rwhitby/glasgow-addons/hardware/usb-pd-addon/usb-pd-addon.pdf

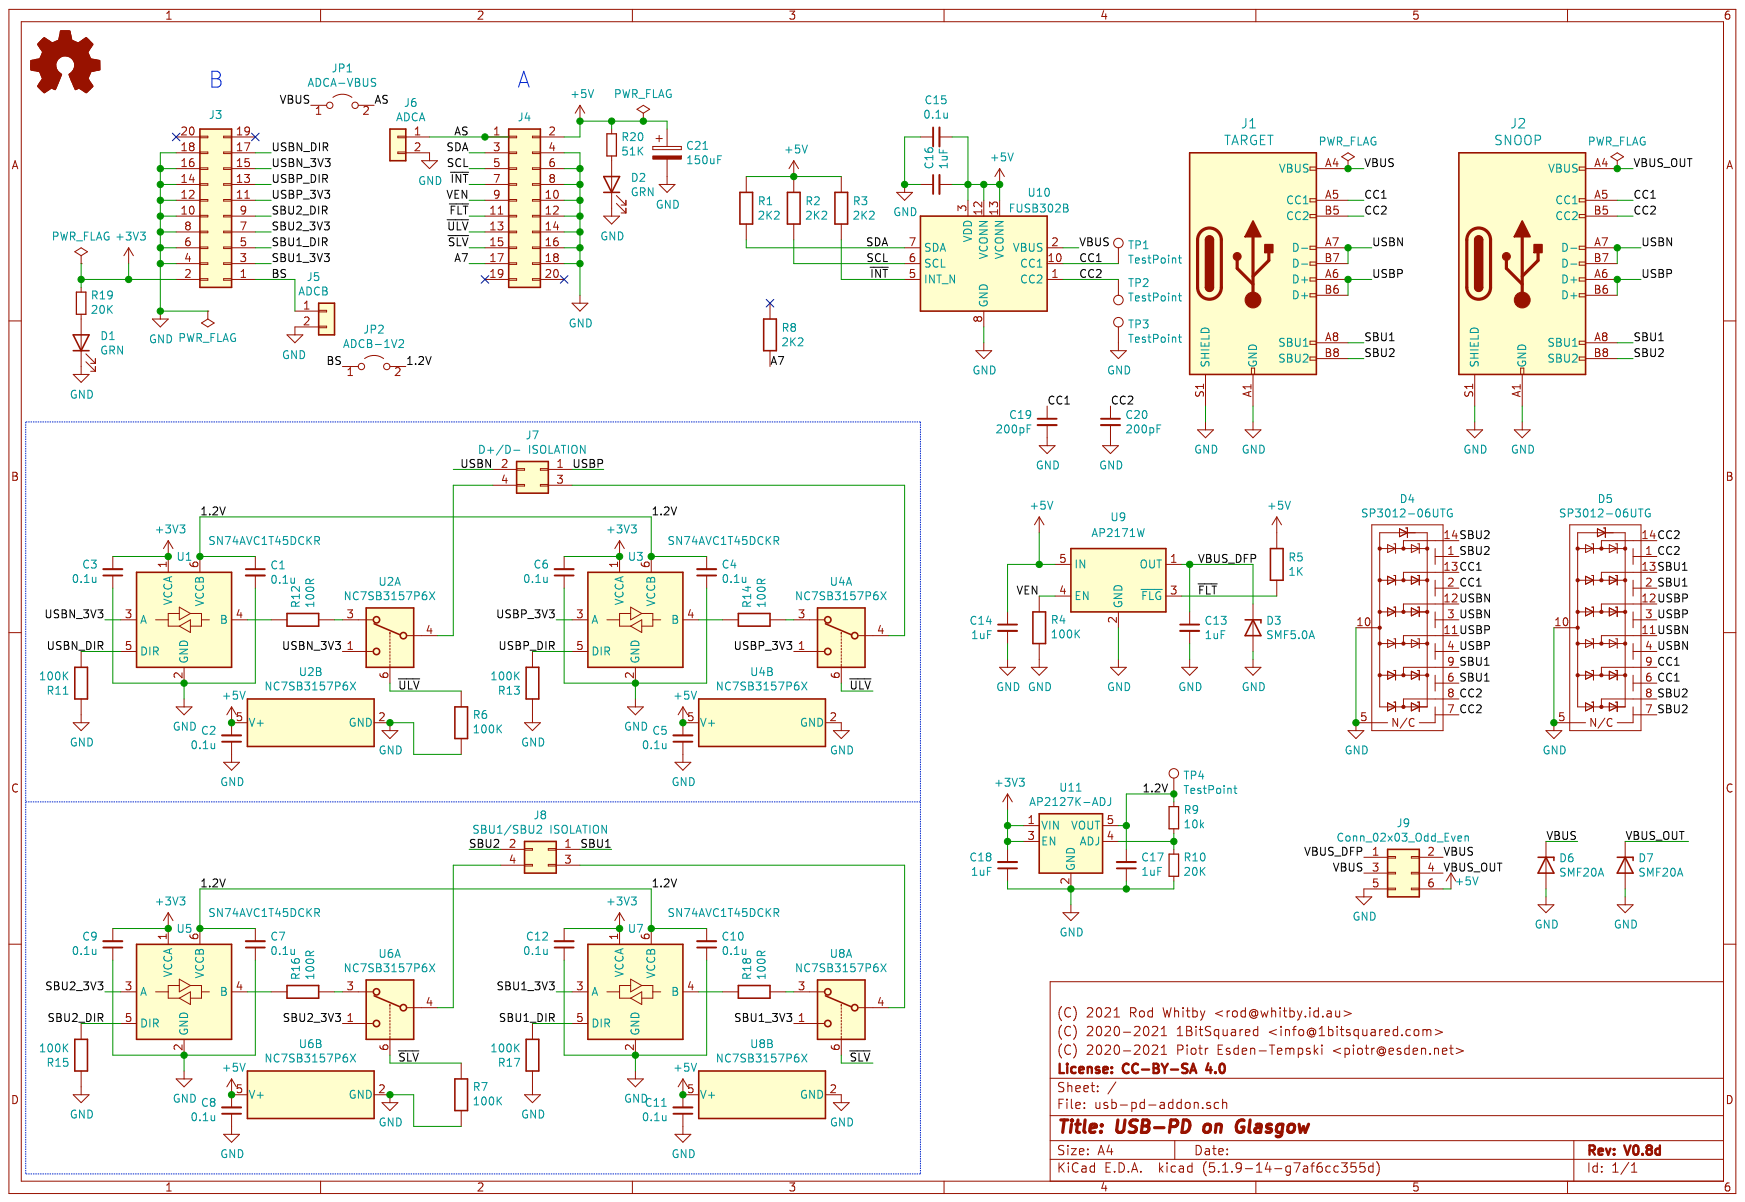
[picture p9: page 1]
