rwhitby/glasgow-addons/hardware/usb-pd-addon/usb-pd-addon.kicad_pcb

## KiCad design hardware/usb-pd-addon/usb-pd-addon.kicad_pcb (2021-03-14)

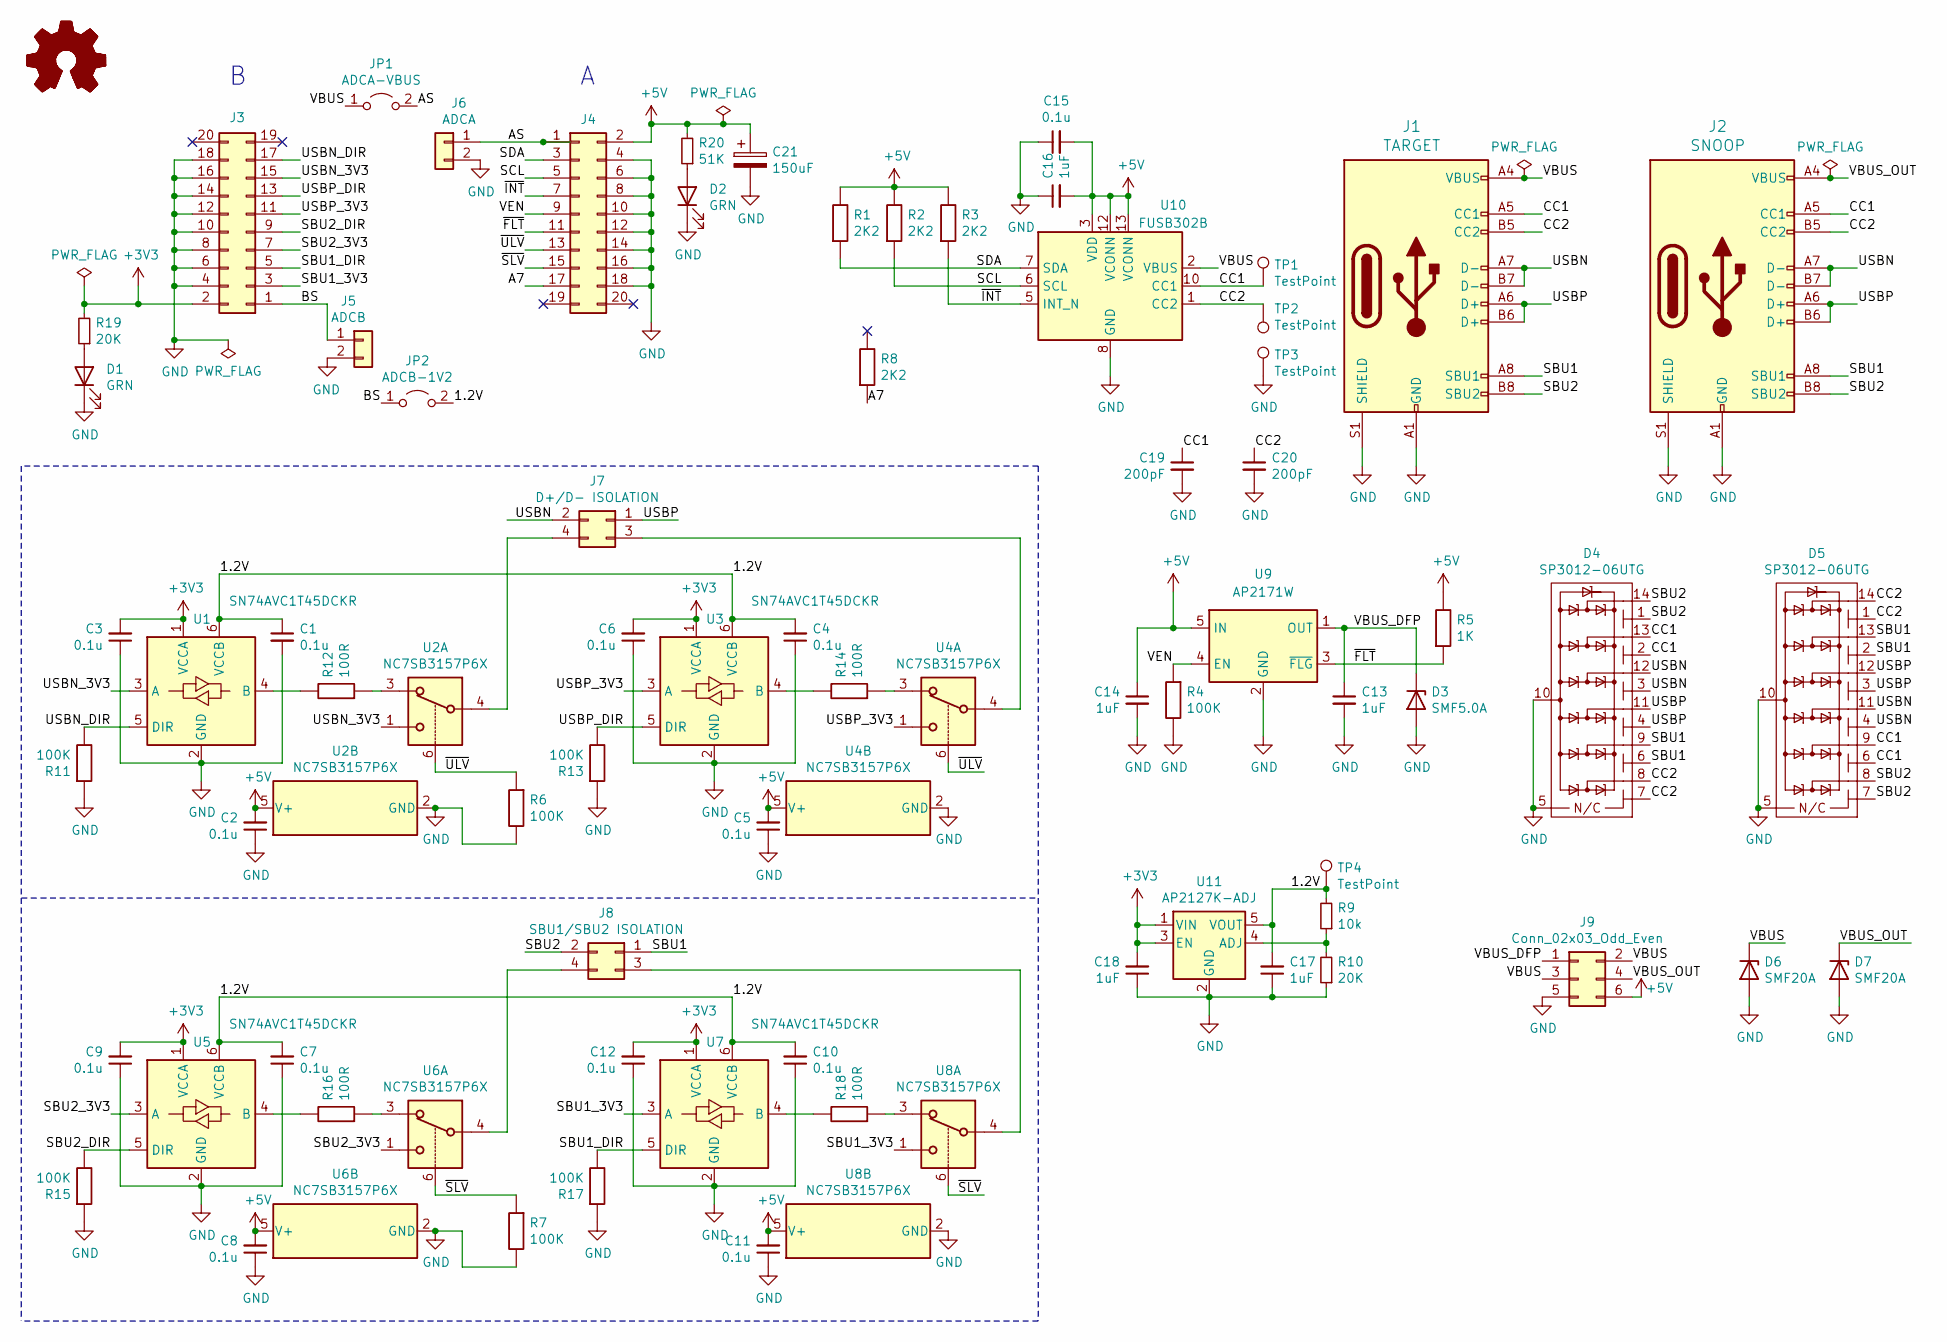
[picture p10: schematic usb-pd-addon.sch, USB-PD on Glasgow]

Parts:
C1, C2, C3, C4, C5, C6, C7, C8, C9, C10, C11, C12, C15: 0.1u; C_0603; LCSC C14663
C13, C14, C16, C17, C18: 1uF; C_0603; LCSC C15849
C19, C20: 200pF; C_0603; LCSC C1600
C21: 150uF; CP_Elec_6.3x7.7; LCSC C250091
D1, D2: GRN; LED_0603_1608Metric; LCSC C72043
D3: SMF5.0A; D_SOD-123F; LCSC C151296
D4, D5: SP3012-06UTG; UDFN-14_3.5x1.35mm_P0.5mm; LCSC C126838
D6, D7: SMF20A; D_SOD-123F; LCSC C151295
J1: TARGET; USB_C_Receptacle_HRO_TYPE-C-31-M-12; LCSC C165948
J2: SNOOP; USB_C_Receptacle_HRO_TYPE-C-31-M-12; LCSC C165948
J3, J4: Conn_02x10_Odd_Even; PinSocket_2x10_P2.54mm_Vertical; LCSC C50982
J5: ADCB; PinHeader_1x02_P2.54mm_Vertical; LCSC C160332
J6: ADCA; PinHeader_1x02_P2.54mm_Vertical; LCSC C160332
J7: D+/D- ISOLATION; PinHeader_2x02_P2.54mm_Vertical
J8: SBU1/SBU2 ISOLATION; PinHeader_2x02_P2.54mm_Vertical
J9: Conn_02x03_Odd_Even; PinHeader_2x03_P2.54mm_Vertical; LCSC C65114
JP1: ADCA-VBUS; SolderJumper-2_P1.3mm_Open_RoundedPad1.0x1.5mm
JP2: ADCB-1V2; SolderJumper-2_P1.3mm_Open_RoundedPad1.0x1.5mm
LOGO1, LOGO2: Logo_Open_Hardware_Small; OSHW-Logo2_7.3x6mm_SilkScreen
R1, R2, R3, R8: 2K2; R_0603; LCSC C4190
R4, R6, R7, R11, R13, R15, R17: 100K; R_0603; LCSC C25803
R5: 1K; R_0603; LCSC C21190
R9: 10k; R_0603; LCSC C25804
R10, R19: 20K; R_0603; LCSC C4184
R12, R14, R16, R18: 100R; R_0603; LCSC C22775
R20: 51K; R_0603; LCSC C23196
TP1, TP2, TP3, TP4: TestPoint; TestPoint_THTPad_1.0x1.0mm_Drill0.5mm
U1, U3, U5, U7: SN74AVC1T45DCKR; SOT-363_SC-70-6; LCSC C133077
U2, U4, U6, U8: NC7SB3157P6X; SOT-363_SC-70-6; LCSC C87403
U9: AP2171W; SOT-23-5; LCSC C110466
U10: FUSB302B; WQFN-14-1EP_2.5x2.5mm_P0.5mm_EP1.45x1.45mm; LCSC C132291
U11: AP2127K-ADJ; SOT-23-5; LCSC C96343

Connections:
+3V3: C3.2, C6.2, C9.2, C12.2, C18.2, J3.2, R19.2, U1.1 (VCCA), U3.1 (VCCA), U5.1 (VCCA), U7.1 (VCCA), U11.1 (VIN), U11.3 (EN)
+5V: C2.2, C5.2, C8.2, C11.2, C14.1, C15.2, C16.2, C21.1, J4.2, J9.6, R1.1, R2.1, R3.1, R5.1, R20.2, U2.5 (V+), U4.5 (V+), U6.5 (V+), U8.5 (V+), U9.5 (IN), U10.3 (VDD), U10.4 (VDD), U10.12 (VCONN), U10.13 (VCONN)
/1.2V: C1.1, C4.2, C7.2, C10.2, C17.2, JP2.2 (B), R9.2, TP4.1, U1.6 (VCCB), U3.6 (VCCB), U5.6 (VCCB), U7.6 (VCCB), U11.5 (VOUT)
/A7: J4.17, R8.2
/AS: J4.1, J6.1, JP1.2 (B)
/BS: J3.1, J5.1, JP2.1 (A)
/CC1: C19.1, D4.2 (N/C), D4.13 (Ch2), D5.6 (N/C), D5.9 (Ch5), J1.A5 (CC1), J2.A5 (CC1), TP1.1, U10.10 (CC1), U10.11 (CC1)
/CC2: C20.1, D4.7 (N/C), D4.8 (Ch6), D5.1 (N/C), D5.14 (Ch1), J1.B5 (CC2), J2.B5 (CC2), TP2.1, U10.1 (CC2), U10.14 (CC2)
/SBU1: D4.6 (N/C), D4.9 (Ch5), D5.2 (N/C), D5.13 (Ch2), J1.A8 (SBU1), J2.A8 (SBU1), J8.1
/SBU1_3V3: J3.3, U7.3 (A), U8.1
/SBU1_DIR: J3.5, R17.1, U7.5 (DIR)
/SBU2: D4.1 (N/C), D4.14 (Ch1), D5.7 (N/C), D5.8 (Ch6), J1.B8 (SBU2), J2.B8 (SBU2), J8.2
/SBU2_3V3: J3.7, U5.3 (A), U6.1
/SBU2_DIR: J3.9, R15.1, U5.5 (DIR)
/SCL: J4.5, R2.2, U10.6 (SCL)
/SDA: J4.3, R1.2, U10.7 (SDA)
/USBN: D4.3 (N/C), D4.12 (Ch3), D5.4 (N/C), D5.11 (Ch4), J1.A7 (D-), J1.B7 (D-), J2.A7 (D-), J2.B7 (D-), J7.2
/USBN_3V3: J3.15, U1.3 (A), U2.1
/USBN_DIR: J3.17, R11.1, U1.5 (DIR)
/USBP: D4.4 (N/C), D4.11 (Ch4), D5.3 (N/C), D5.12 (Ch3), J1.A6 (D+), J1.B6 (D+), J2.A6 (D+), J2.B6 (D+), J7.1
/USBP_3V3: J3.11, U3.3 (A), U4.1
/USBP_DIR: J3.13, R13.1, U3.5 (DIR)
/VBUS: D6.1 (K), J1.A4 (VBUS), J1.A9 (VBUS), J1.B4 (VBUS), J1.B9 (VBUS), J9.2, J9.3, JP1.1 (A), U10.2 (VBUS)
/VBUS_DFP: C13.1, D3.1 (K), J9.1, U9.1 (OUT)
/VBUS_OUT: D7.1 (K), J2.A4 (VBUS), J2.A9 (VBUS), J2.B4 (VBUS), J2.B9 (VBUS), J9.4
/VEN: J4.9, R4.2, U9.4 (EN)
/~FLT: J4.11, R5.2, U9.3 (~FLG)
/~INT: J4.7, R3.2, U10.5 (INT_N)
/~SLV: J4.15, R7.2, U6.6, U8.6
/~ULV: J4.13, R6.2, U2.6, U4.6
GND: C1.2, C2.1, C3.1, C4.1, C5.1, C6.1, C7.1, C8.1, C9.1, C10.1, C11.1, C12.1, C13.2, C14.2, C15.1, C16.1, C17.1, C18.1, C19.2, C20.2, C21.2, D1.1 (K), D2.1 (K), D3.2 (A), D4.5 (N/C), D4.10 (GND), D5.5 (N/C), D5.10 (GND), D6.2 (A), D7.2 (A), J1.A1 (GND), J1.A12 (GND), J1.B1 (GND), J1.B12 (GND), J1.S1 (SHIELD), J2.A1 (GND), J2.A12 (GND), J2.B1 (GND), J2.B12 (GND), J2.S1 (SHIELD), J3.4, J3.6, J3.8, J3.10, J3.12, J3.14, J3.16, J3.18, J4.4, J4.6, J4.8, J4.10, J4.12, J4.14, J4.16, J4.18, J5.2, J6.2, J9.5, R4.1, R6.1, R7.1, R10.1, R11.2, R13.2, R15.2, R17.2, TP3.1, U1.2 (GND), U2.2 (GND), U3.2 (GND), U4.2 (GND), U5.2 (GND), U6.2 (GND), U7.2 (GND), U8.2 (GND), U9.2 (GND), U10.8 (GND), U10.9 (GND), U10.15 (GND), U11.2 (GND)
unnamed: D1.2 (A), R19.1
unnamed: D2.2 (A), R20.1
unnamed: J7.3, U4.4
unnamed: J7.4, U2.4
unnamed: J8.3, U8.4
unnamed: J8.4, U6.4
unnamed: R9.1, R10.2, U11.4 (ADJ)
unnamed: R12.1, U1.4 (B)
unnamed: R12.2, U2.3
unnamed: R14.1, U3.4 (B)
unnamed: R14.2, U4.3
unnamed: R16.1, U5.4 (B)
unnamed: R16.2, U6.3
unnamed: R18.1, U7.4 (B)
unnamed: R18.2, U8.3

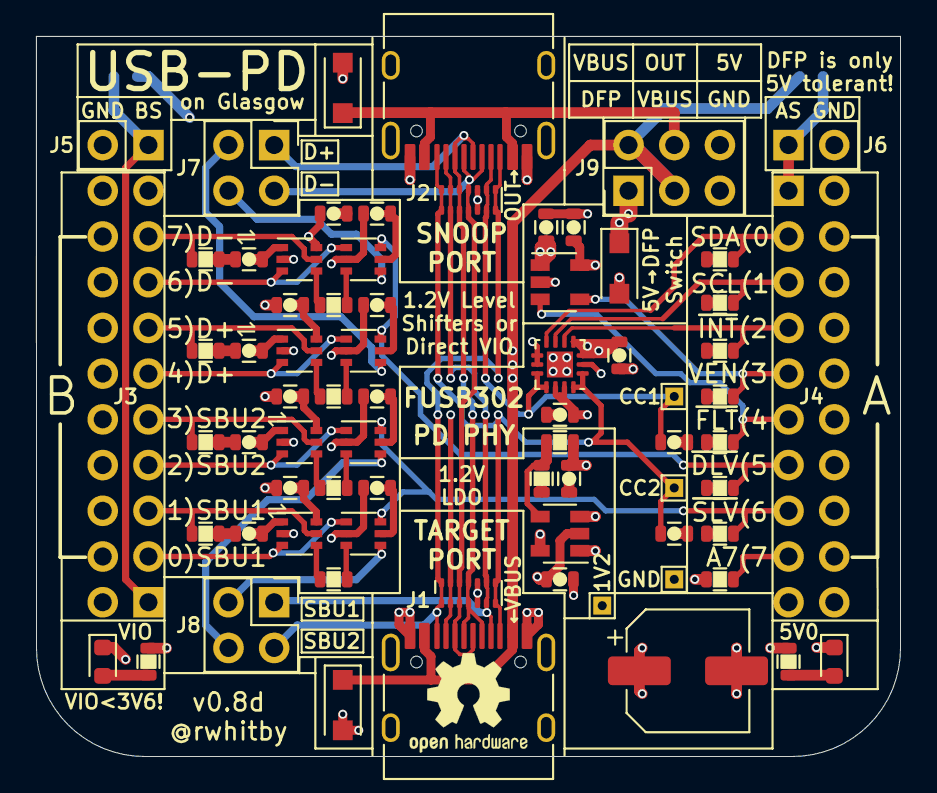
[picture p11: board usb-pd-addon.kicad_pcb from above]

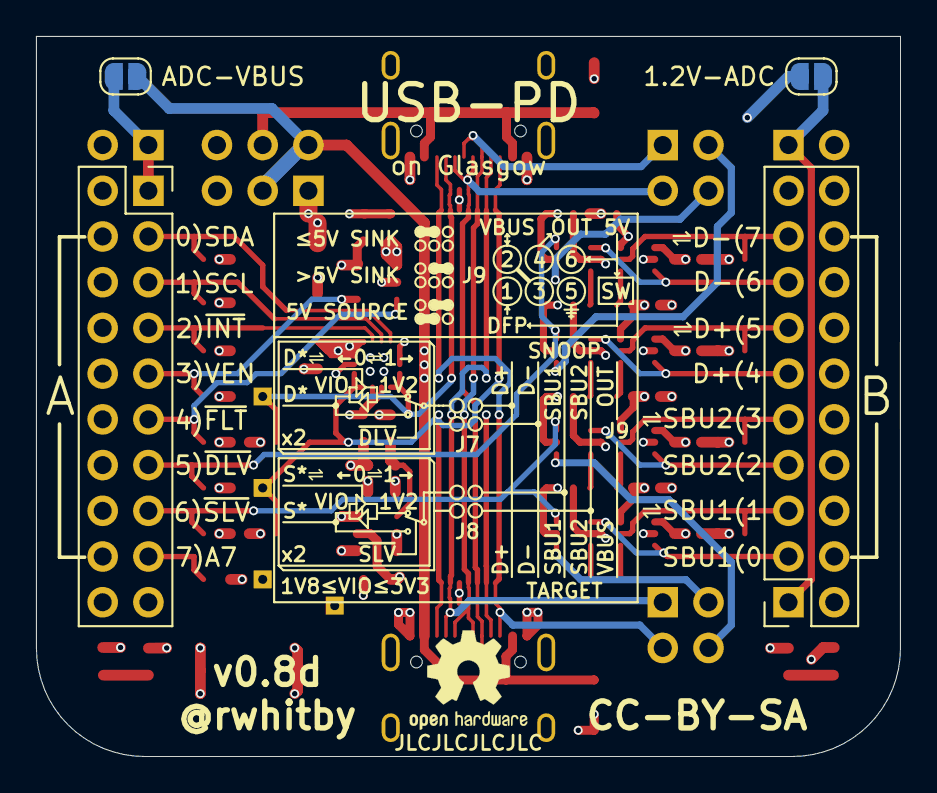
[picture p12: board usb-pd-addon.kicad_pcb from below]

Board: 4 copper layers, 48.0 x 40.0 mm, 76 parts (5 on the bottom side), 46 nets.
