rwhitby/glasgow-addons/(commit log)

2021-02-07 Initial version of USB-PD add-on.
    [usb-pd-addon.kicad_pcb, usb-pd-addon.sch]
2021-02-09 v0.2a: Added adjustable LDOs for the level shifter reference voltages for USB and SBU pairs.
    [usb-pd-addon.kicad_pcb, usb-pd-addon.sch]
2021-02-09 Updated USB-C symbol, no functional change.
    [usb-pd-addon.kicad_pcb, usb-pd-addon.sch]
2021-02-11 Added more resistors to fine tune level shifter reference voltages.
    [usb-pd-addon.kicad_pcb, usb-pd-addon.sch]
2021-02-12 Added bypass caps.
    [usb-pd-addon.kicad_pcb, usb-pd-addon.sch]
2021-02-12 Corrected D+ pullup circuitry and added bypass cap.
    [usb-pd-addon.kicad_pcb, usb-pd-addon.sch]
2021-02-12 Better mnemonic for the FS pull-up switch enable.
    [usb-pd-addon.kicad_pcb, usb-pd-addon.sch]
2021-02-13 Added LEDs and a README.
    [usb-pd-addon.kicad_pcb, usb-pd-addon.sch]
2021-02-13 Changed 5V LED resistor to 51K
    [usb-pd-addon.kicad_pcb, usb-pd-addon.sch]
2021-02-14 Updated README, better silk for voltage control jumpers.
    [usb-pd-addon.kicad_pcb, usb-pd-addon.sch]
2021-02-16 Remove the D+ pullup, cause Glasgow will not support Luna USB stack. Added 2 spare SOT23 footprints.
    [usb-pd-addon.kicad_pcb, usb-pd-addon.sch]
2021-02-19 v0.3a: revamped the level shifting, reusing glasgow hardware for 1.8V to 3.3V
    [usb-pd-addon.kicad_pcb, usb-pd-addon.sch]
2021-02-19 v0.4a: Added decoupling for FUSB302, and protection for DFP mode operation.
    [usb-pd-addon.kicad_pcb, usb-pd-addon.sch]
2021-02-22 v0.5a: bulk capacitor for 5V supply and lots of protection added, added more silk.
    [usb-pd-addon.kicad_pcb, usb-pd-addon.sch]
2021-02-24 v0.6a: Changed to 4 layer board, added caps on CC1/CC2, squared top edge of board, increased silk legibility.
    [usb-pd-addon.kicad_pcb, usb-pd-addon.sch]
2021-02-24 Update version on schematic too.
    [usb-pd-addon.sch]
2021-02-24 Add inner layers to PCB PDF.
2021-02-24 Updated power plane regions.
    [usb-pd-addon.kicad_pcb]
2021-02-25 v0.7a: analog switches instead of jumpers
    [usb-pd-addon.kicad_pcb, usb-pd-addon.sch]
2021-02-26 Interim version for review
    Changed level shifters to smaller footprint.
    Added pull-down resistors on direction signals and analog switch selects.
    [usb-pd-addon.kicad_pcb, usb-pd-addon.sch]
2021-03-01 Widened some power traces.
    [usb-pd-addon.kicad_pcb]
2021-03-01 v0.8a: Colocated D+/D- and SBU1/SBU2 jumpers. Moved ASA/ASB jumpers away from Glasgow headers.
    [usb-pd-addon.kicad_pcb, usb-pd-addon.sch]
2021-03-01 Small silk improvements
    [usb-pd-addon.kicad_pcb]
2021-03-02 v0.8b: Lots of silk improvements on front side. Relayout of center column of wires. Extended USB-C connectors past board edge.
    [usb-pd-addon.kicad_pcb, usb-pd-addon.sch]
2021-03-05 Ordered annotations and rotated components.
    [usb-pd-addon.kicad_pcb, usb-pd-addon.sch]
2021-03-07 v0.8c: Added 1.2V test point and more front silk improvements.
    [usb-pd-addon.kicad_pcb, usb-pd-addon.sch]
2021-03-14 v0.8d: Close to final rear silk documentation.
    [usb-pd-addon.kicad_pcb, usb-pd-addon.sch]
2021-03-14 Updated the README to reflect current status.
