rwhitby/glasgow-addons/(notices)

Notices in the files:
hardware/usb-pd-addon/usb-pd-addon.kicad_pcb:
License: CC-BY-SA 4.0
(C) 2020-2021 1BitSquared
(C) 2020-2021 Piotr Esden-Tempski
(C) 2021 Rod Whitby
CC-BY-SA
